savergiggio/AquaMind/images/Screenshot_20261013_233114.jpg

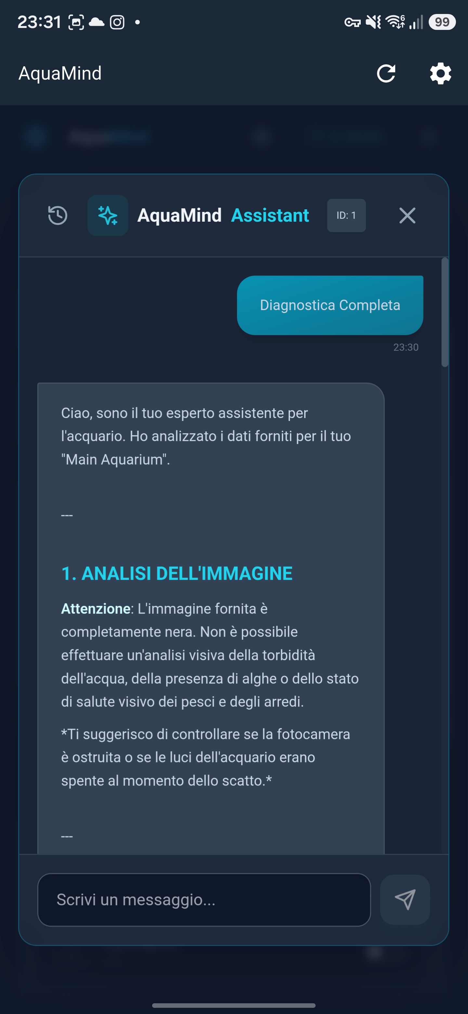
images/Screenshot_20261013_233114.jpg
