savergiggio/AquaMind/images/Screenshot_20261013_233128.jpg

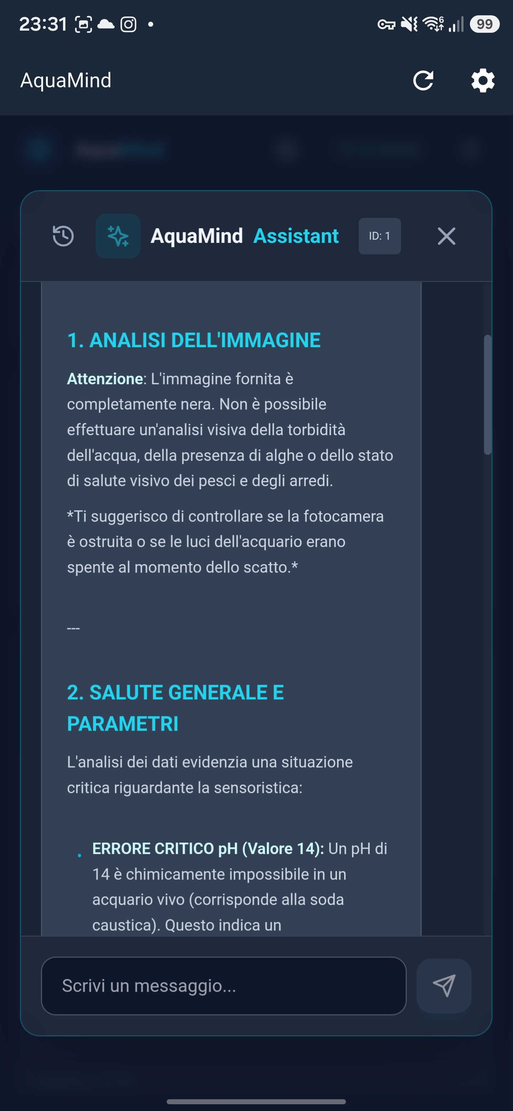
images/Screenshot_20261013_233128.jpg
