savergiggio/AquaMind/images/Screenshot_20261013_233233.jpg

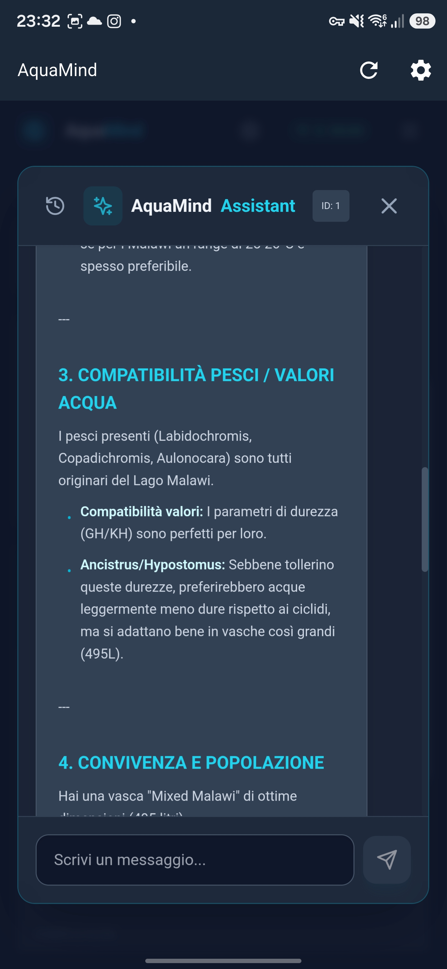
images/Screenshot_20261013_233233.jpg
