savergiggio/AquaMind/to_upload/3D/case/AquaMind.step

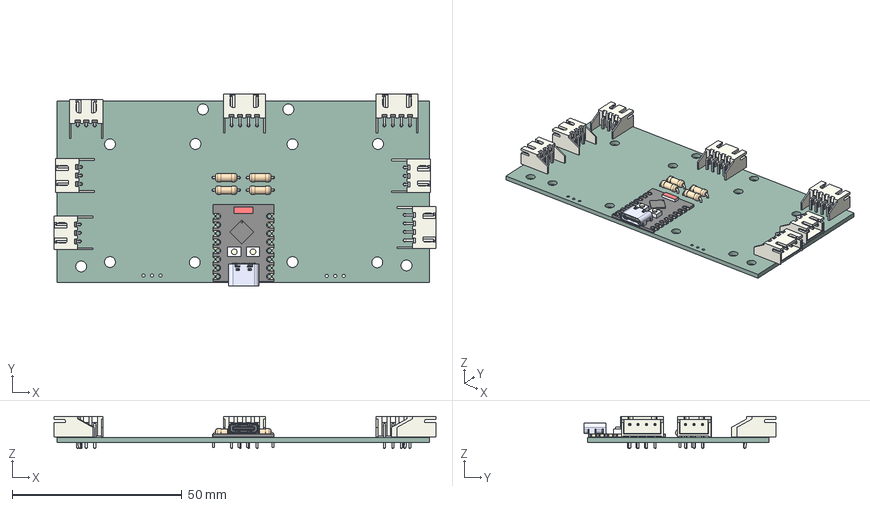
[picture p35: CAD file, 2026-09-27, last stored version]
to_upload/3D/case/AquaMind.step
112.6 x 56.5 x 9.50 mm
JST_XH_S4B-XH-A_1x04_P2.50mm_Horizontal x 3
R_Axial_DIN0207_L6.3mm_D2.5mm_P7.62mm_Horizontal x 4
Board c3mini
USB C
components (other)^ESP32-C3 SuperMini
JST_XH_S3B-XH-A-1_1x03_P2.50mm_Horizontal x 4
AquaMind_PCB
