savergiggio/AquaMind/to_upload/3D/display/display_aquamind.STEP

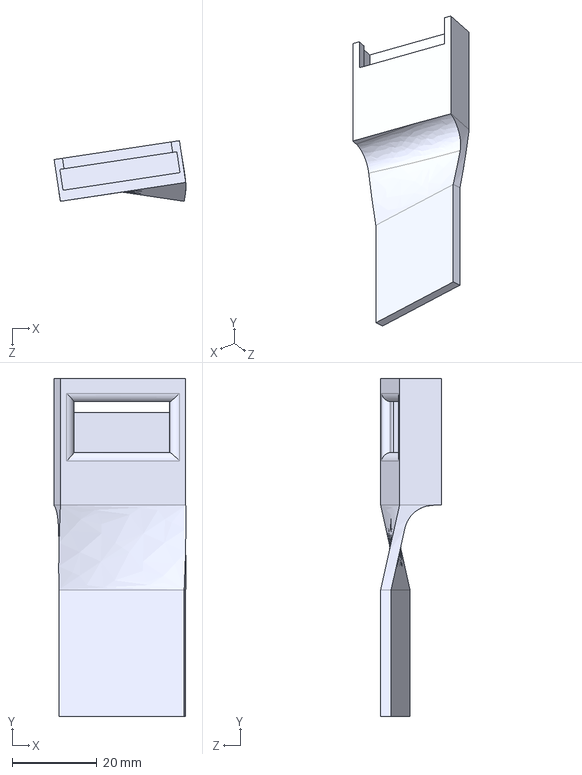
[picture p36: CAD file, 2026-09-27, last stored version]
to_upload/3D/display/display_aquamind.STEP
31.2 x 80.0 x 14.4 mm
