savergiggio/AquaMind/to_upload/pcb/kicad/AquaMind.step

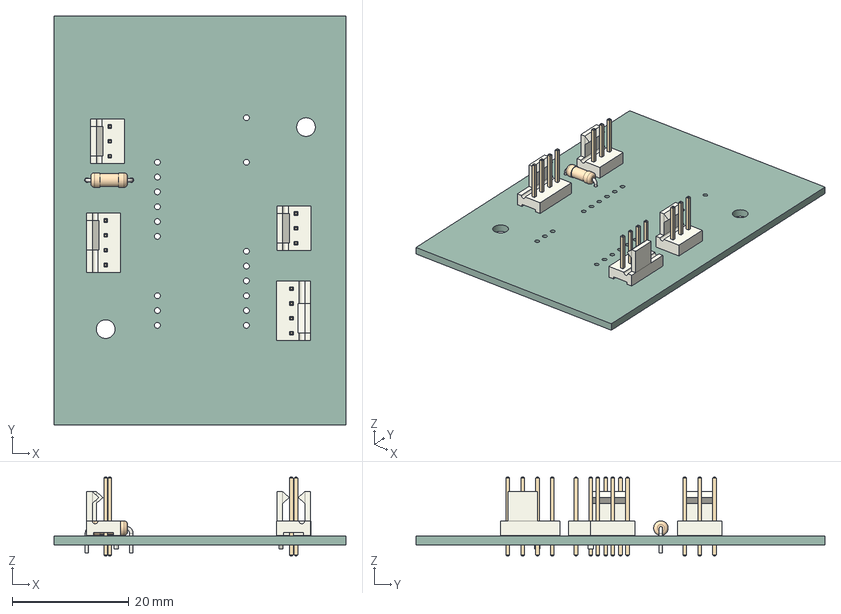
[picture p37: CAD file, 2026-09-27, last stored version]
to_upload/pcb/kicad/AquaMind.step
50.0 x 70.0 x 13.5 mm
R_Axial_DIN0207_L6.3mm_D2.5mm_P7.62mm_Horizontal
FanPinHeader_1x04_P2.54mm_Vertical x 2
FanPinHeader_1x03_P2.54mm_Vertical x 2
AquaMind_PCB
