savergiggio/AquaMind/to_upload/3D/case/spessore.STEP

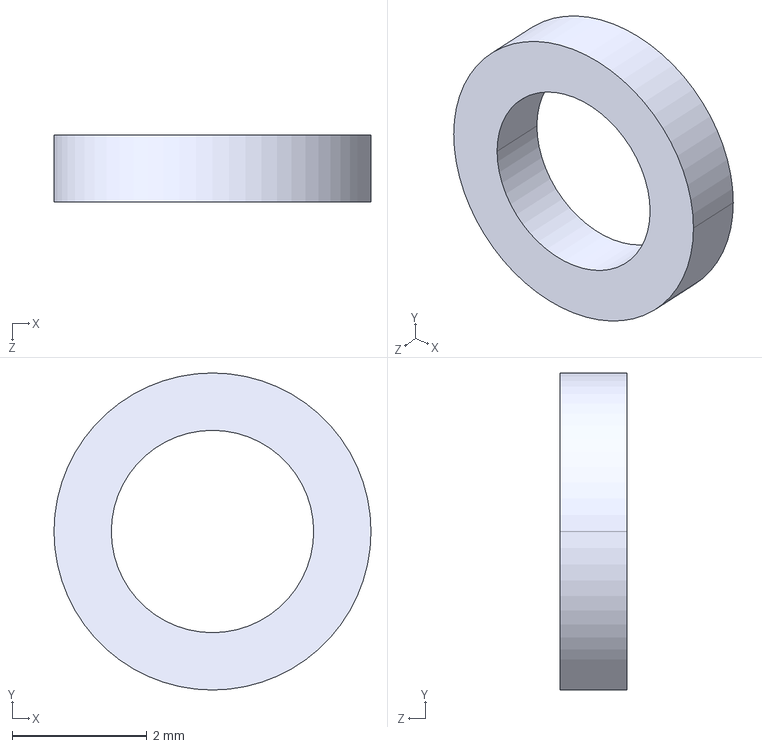
[picture p38: CAD file, 2026-09-27, last stored version]
to_upload/3D/case/spessore.STEP
4.70 x 4.70 x 1.00 mm
