savergiggio/AquaMind/to_upload/3D/display/attacco_vetro_53mm.STEP

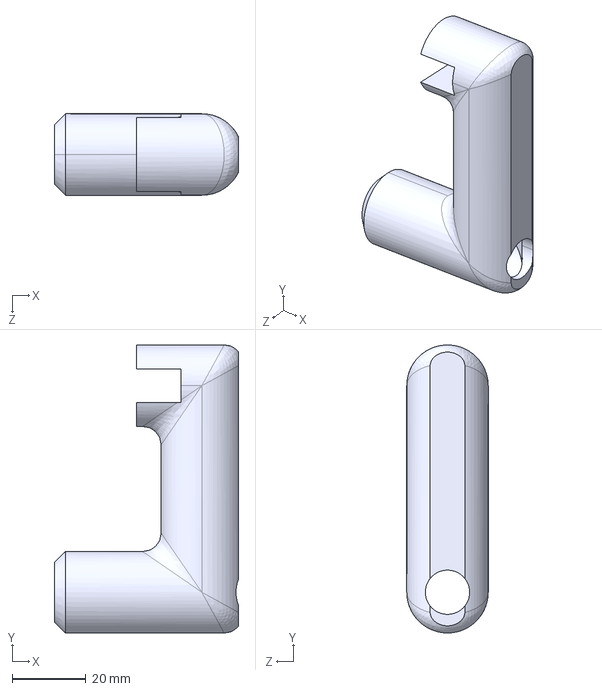
[picture p39: CAD file, 2026-09-27, last stored version]
to_upload/3D/display/attacco_vetro_53mm.STEP
50.0 x 78.1 x 22.1 mm
