savergiggio/AquaMind/to_upload/3D/case/base.STEP

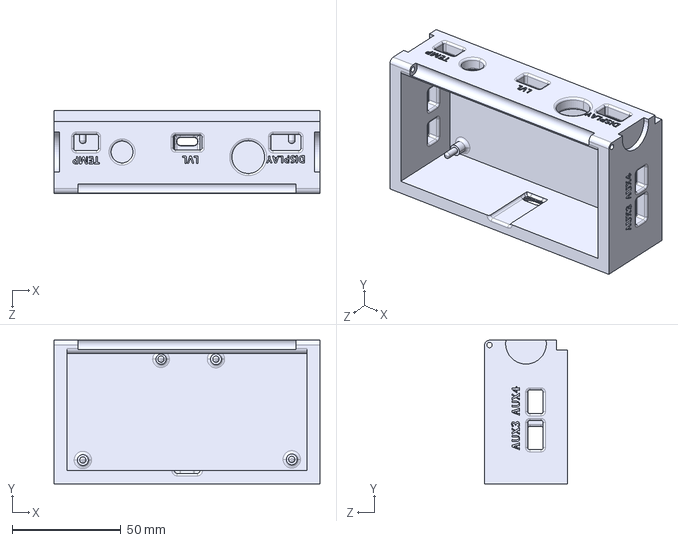
[picture p40: CAD file, 2026-09-27, last stored version]
to_upload/3D/case/base.STEP
122.1 x 65.9 x 38.0 mm
