savergiggio/AquaMind/to_upload/3D/case/coperchio.STEP

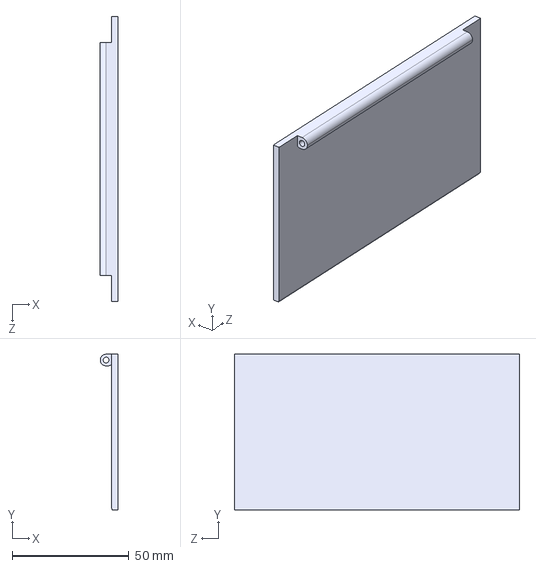
[picture p41: CAD file, 2026-09-27, last stored version]
to_upload/3D/case/coperchio.STEP
7.50 x 66.7 x 122.1 mm
