savergiggio/AquaMind/to_upload/3D/case/attacco_sensori.STEP

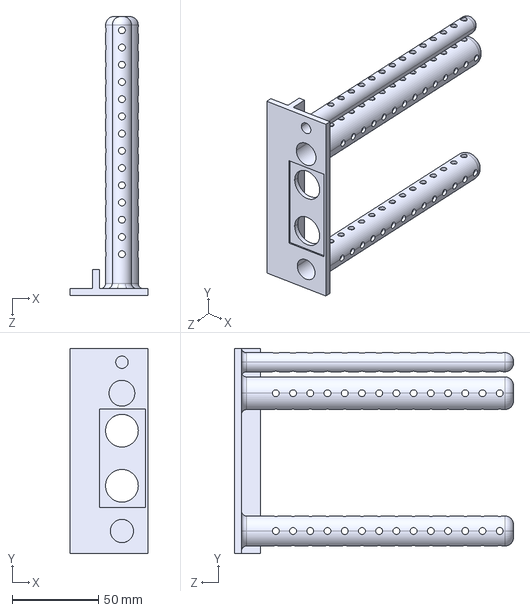
[picture p42: CAD file, 2026-09-27, last stored version]
to_upload/3D/case/attacco_sensori.STEP
45.0 x 119.1 x 162.0 mm
