savergiggio/AquaMind/to_upload/3D/case/tappo.STEP

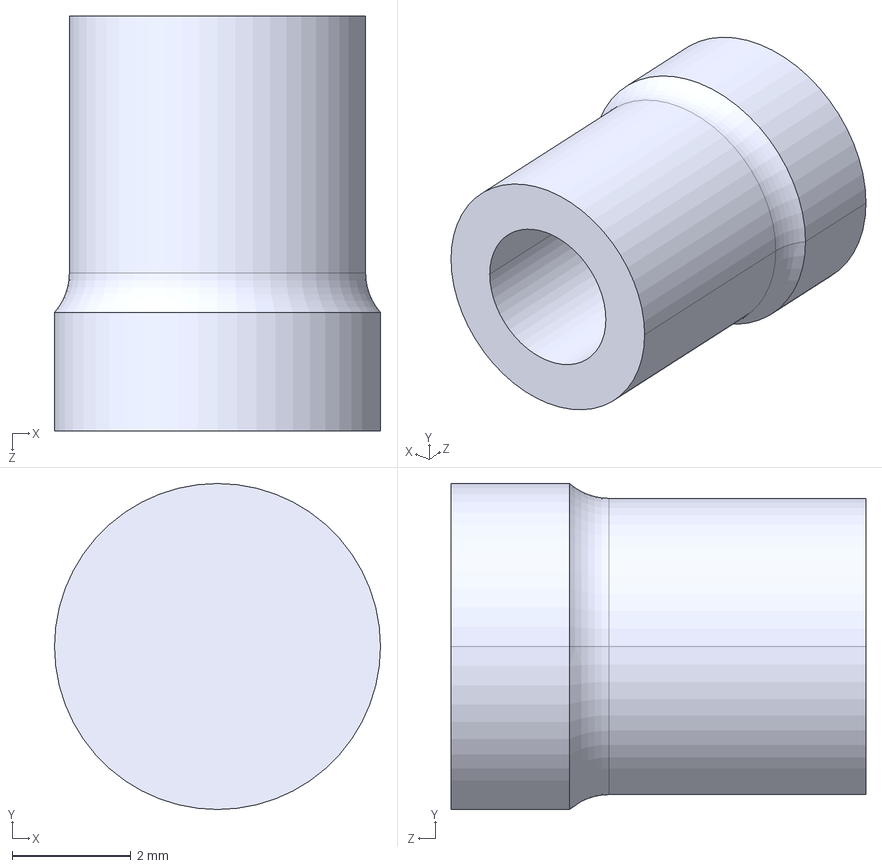
[picture p43: CAD file, 2026-09-27, last stored version]
to_upload/3D/case/tappo.STEP
5.50 x 5.50 x 7.00 mm
