savergiggio/AquaMind/(list of files, cad)

Other CAD files:
3D/case/attacco_sensori.SLDPRT
3D/case/base.SLDPRT
3D/case/coperchio.SLDPRT
3D/case/spessore.SLDPRT
3D/case/tappo.SLDPRT
3D/display/attacco_vetro_53mm.SLDPRT
3D/display/display_aquamind.SLDPRT
to_upload/3D/case/attacco_sensori.SLDPRT
to_upload/3D/case/base.SLDPRT
to_upload/3D/case/coperchio.SLDPRT
to_upload/3D/case/spessore.SLDPRT
to_upload/3D/case/tappo.SLDPRT
to_upload/3D/display/attacco_vetro_53mm.SLDPRT
to_upload/3D/display/display_aquamind.SLDPRT
