savergiggio/AquaMind/pcb/kicad/AquaMind.kicad_pcb

## KiCad design to_upload/pcb/kicad/AquaMind.kicad_pcb (2026-09-27, last stored version)

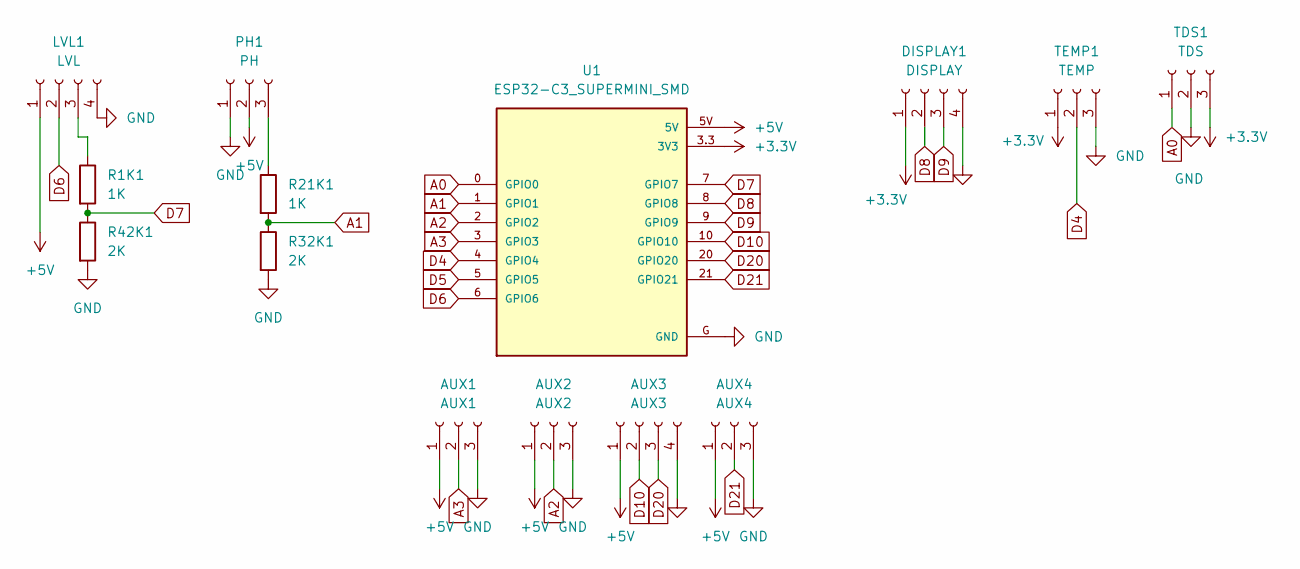
[picture p44: schematic AquaMind.kicad_sch]

Parts:
AUX1: AUX1; JST_XH_S3B-XH-A-1_1x03_P2.50mm_Horizontal
AUX2: AUX2; JST_XH_S3B-XH-A-1_1x03_P2.50mm_Horizontal
AUX3: AUX3; JST_XH_S4B-XH-A_1x04_P2.50mm_Horizontal
AUX4: AUX4; JST_XH_S3B-XH-A-1_1x03_P2.50mm_Horizontal
DISPLAY1: DISPLAY; JST_XH_S4B-XH-A_1x04_P2.50mm_Horizontal
LVL1: LVL; JST_XH_S4B-XH-A_1x04_P2.50mm_Horizontal
PH1: PH; JST_EH_B3B-EH-A_1x03_P2.50mm_Vertical
R1K1, R21K1: 1K; R_Axial_DIN0207_L6.3mm_D2.5mm_P7.62mm_Horizontal
R32K1, R42K1: 2K; R_Axial_DIN0207_L6.3mm_D2.5mm_P7.62mm_Horizontal
TDS1: TDS; JST_EH_B3B-EH-A_1x03_P2.50mm_Vertical
TEMP1: TEMP; JST_XH_S3B-XH-A-1_1x03_P2.50mm_Horizontal
U1: ESP32-C3_SUPERMINI_SMD; MODULE_ESP32-C3_SUPERMINI

Connections:
+3.3V: DISPLAY1.1, TDS1.3, TEMP1.1, U1.3.3 (3V3)
+5V: AUX1.1, AUX2.1, AUX3.1, AUX4.1, LVL1.1, PH1.2, U1.5V
A0: TDS1.1, U1.0 (GPIO0)
A1: R21K1.2, R32K1.1, U1.1 (GPIO1)
A2: AUX2.2, U1.2 (GPIO2)
A3: AUX1.2, U1.3 (GPIO3)
D4: TEMP1.2, U1.4 (GPIO4)
D5: U1.5 (GPIO5)
D6: LVL1.2, U1.6 (GPIO6)
D7: R1K1.2, R42K1.1, U1.7 (GPIO7)
D8: DISPLAY1.2, U1.8 (GPIO8)
D9: DISPLAY1.3, U1.9 (GPIO9)
D10: AUX3.2, U1.10 (GPIO10)
D20: AUX3.3, U1.20 (GPIO20)
D21: AUX4.2, U1.21 (GPIO21)
GND: AUX1.3, AUX2.3, AUX3.4, AUX4.3, DISPLAY1.4, LVL1.4, PH1.1, R32K1.2, R42K1.2, TDS1.2, TEMP1.3, U1.G (GND)
unnamed: LVL1.3, R1K1.1
unnamed: PH1.3, R21K1.1

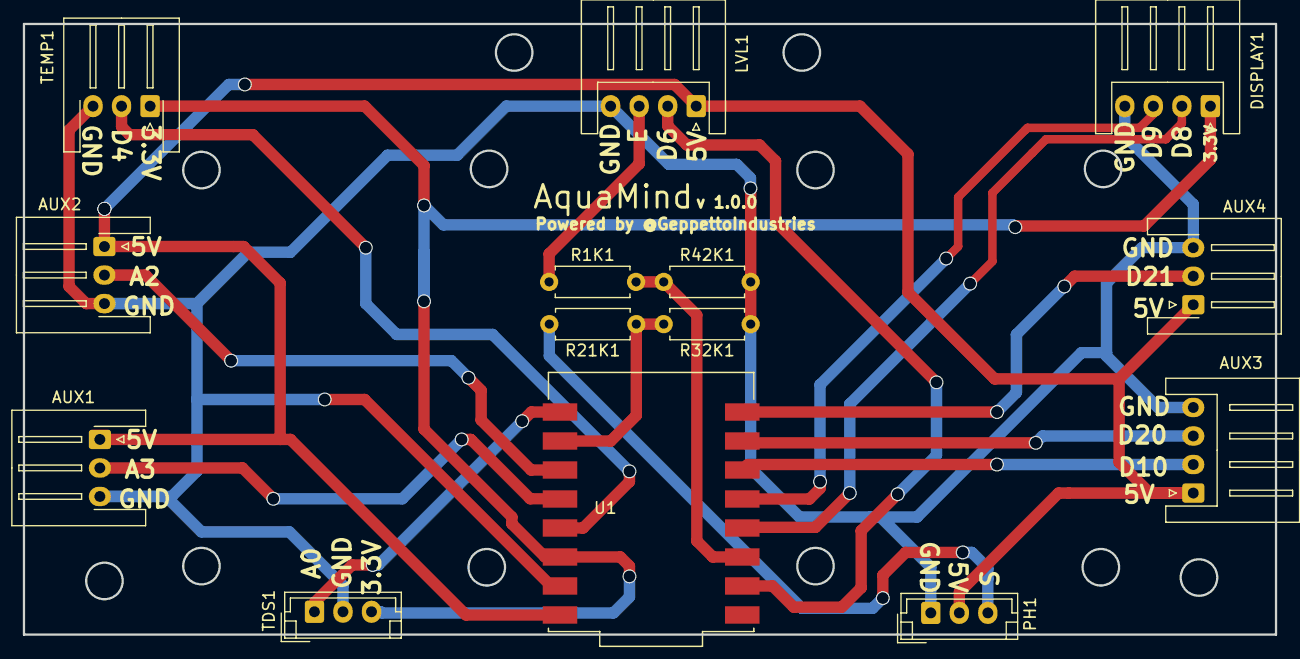
[picture p45: board AquaMind.kicad_pcb from above]

Board: 2 copper layers, 109.7 x 53.5 mm, 14 parts (0 on the bottom side), 17 nets.
