savergiggio/AquaMind/(commit log)

2026-10-23 Reorganize home page: built prototype, Web UI, Mobile app, 3D models sections
2026-10-27 Add PCBWay sponsorship details to README
    Added a sponsorship section for PCBWay with a thank you note and details about the PCB production process.
2026-10-27 Edit README to streamline PCBWay experience section
    Removed redundant text about the usefulness of having the real PCB in hand.
